kleinix16/Diplomova-Praca/media/Testovanie (1).jpg

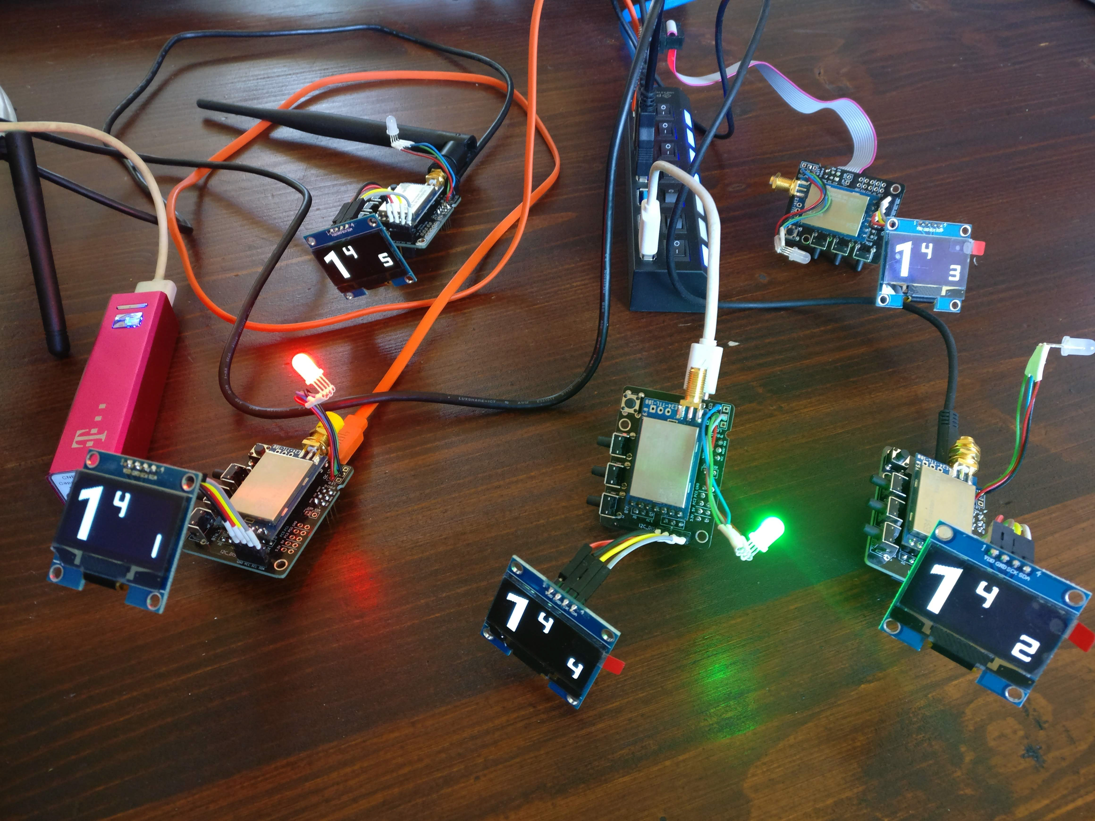
media/Testovanie (1).jpg
