kleinix16/Diplomova-Praca/media/SJ_Nasadenie do prevadzky (1).jpg

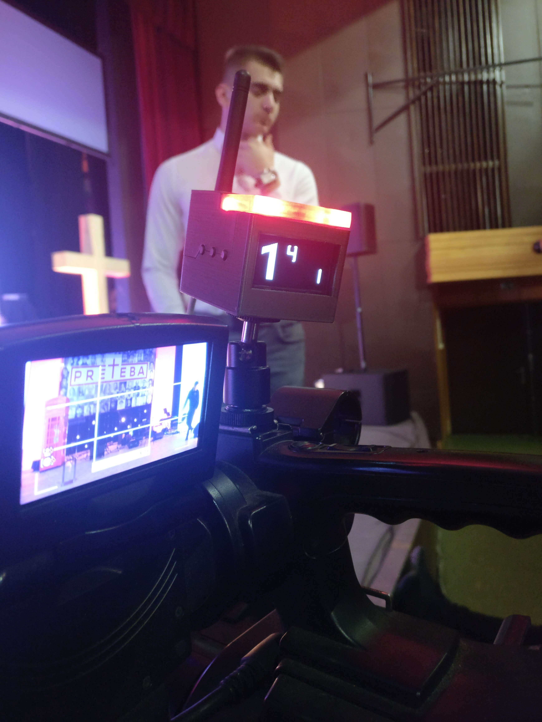
media/SJ_Nasadenie do prevadzky (1).jpg
