kleinix16/Diplomova-Praca/README.md

# Diplomová práca - Komunikačný systém pre kameramanov

Autor: Bc. Tomáš Klein  
Vedúci práce:  prof. Ing. Juraj Miček, PhD.  
Registračné číslo:  28360820192562  
Rok vydania: Žilina, 2019 

Abstrakt: Diplomová práca sa zaoberá riešením problému komunikácie medzi režisérom a kameramanmi pri vytváraní kamerového záznamu pomocou zariadenia video-strižňa. Práca popisuje vytvorenie komunikačného systému, ktorý bude na kamery prenášať Tally svetelnú signalizáciu využitia kamier a krátke textové správy odosielané z Android zariadenia. V úvode práce je popísaná bezdrôtová komunikácia, so zameraním na bezlicenčné frekvenčné pásma. Ďalej práca obsahuje analýzu zadania, v ktorej je podrobnejšie rozobraný návrh celého systému. Táto časť obsahuje porovnanie a výber komponentov komunikačného systému. Implementačná časť práce sa venuje prepojeniu všetkých analyzovaných komponentov a obsahuje základné postupy a algoritmy, využívané pri riešení. 

Kľúčové slová:  ISM, Tally, Mikrokontrolér, Android, Bluetooth   

Súbory: dokumentácia, zdrojové kódy, android aplikácia, 3D model obalu, schémey, diagramy
