kleinix16/Diplomova-Praca/dokumentacia/DP.pptx

## Komunikačný systém pre kameramanov

ŽILINSKÁ UNIVERZITA V ŽILINE
FAKULTA RIADENIA A INFORMATIKY

Diplomová práca
Bc. Tomáš Klein (557478)
Registračné číslo: 28360820192562
Vedúci práce: prof. Ing. Juraj Miček, PhD.

## Ciele práce

- Vytvorenie komunikačného systém pre kameramanov, ktorý spolupracujú na vytvorení spoločného video-záznamu – napr. živý prenos ľadového hokeja
- Tally svetelná signalizácia
- Bezdrôtový prenos

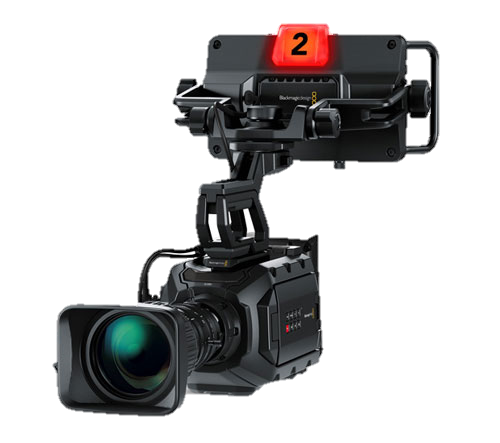
[picture p3: figure]

## Popis systému

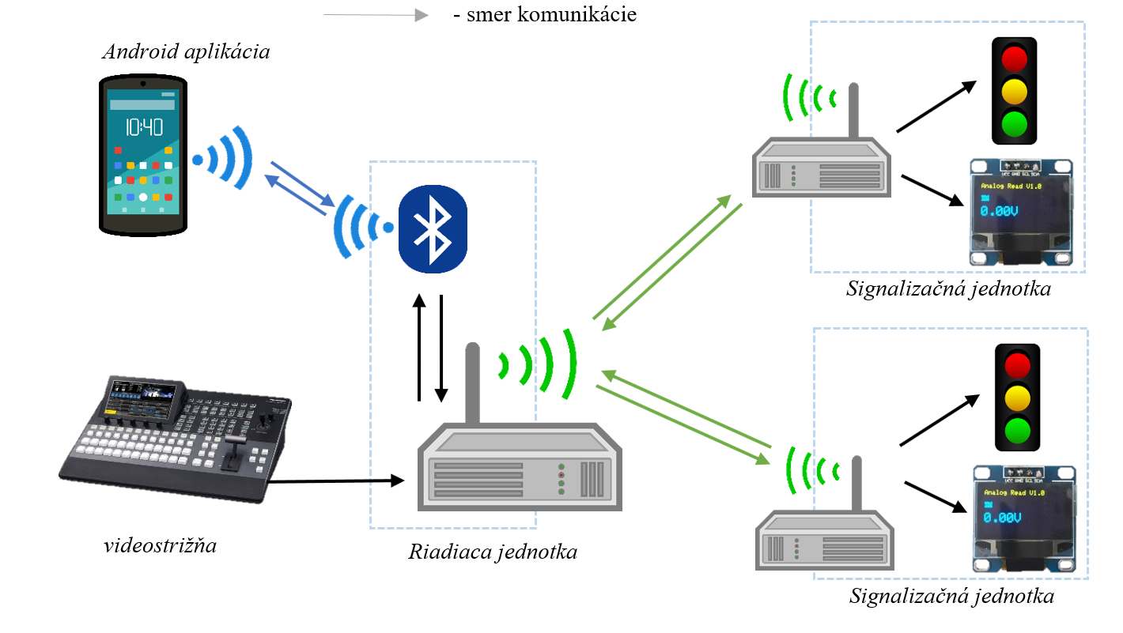
[picture p4: figure]

## Bezdrôtový prenos

- Analýza bezlicenčných pásiem
  - 433 – 434 MHz
  - 863 – 870 MHz
  - 2400 – 2500 MHz
- Výber vhodného modulu
  - Pomer cena/kvalita
  - Možnosť výmeny modulu na iný
  - Firma CDEbyte

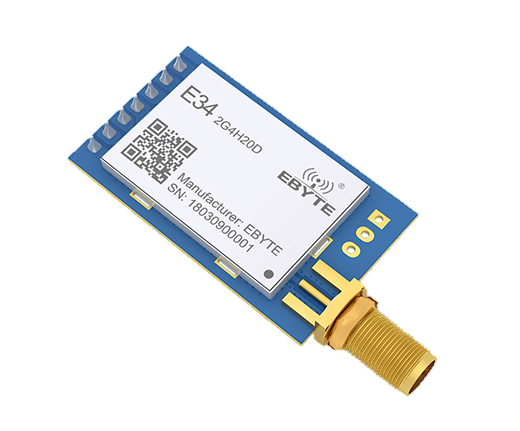
[picture p5: figure]

## Riadiaca stanica

- Zber dát z video-strižňe
- Komunikácia s Android aplikáciou pomocou Bluetooth
- Komunikácia so signalizačnými jednotkami
- Android aplikácia – MIT APP Inventor
  - Programovanie pomocou online grafického prostredia
  - Posielanie a prijímanie textových správ

## Slide 6

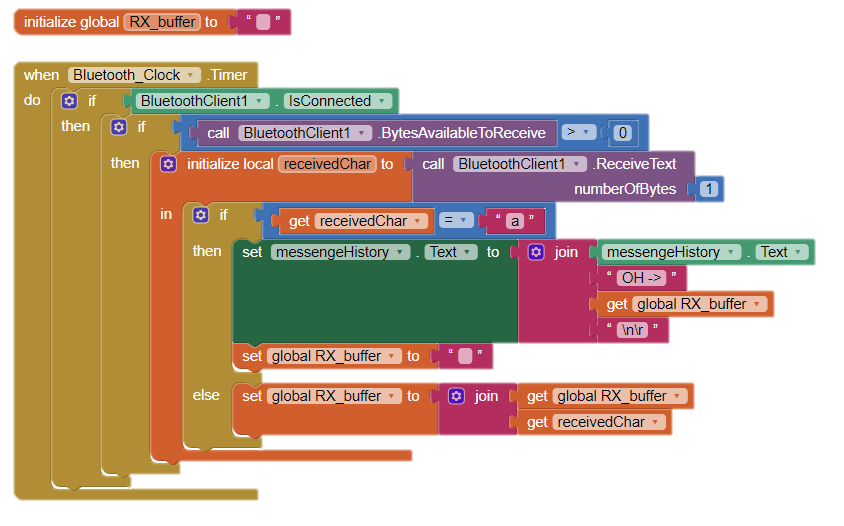
[picture p6: figure]

## Signalizačná jednotka

- Komunikácia s riadiacou stanicou
- Riadenie LED diód
- Zobrazovanie dát na displeji
- Odpovedanie na textové správy
- Napájanie z USB rozhrania
- Dôraz na malé rozmery a estetickú časť

## Výhody riešenia

- Možnosť prispôsobenia systému
- Cena
- Rozšíriteľnosť funkcionality
  - Android aplikácia
  - Možnosť vzdialeného ovládania video-strižne
  - Jednosmerný prenos hlasových povelov z réžie

## Záver

- Ciele boli splnené
- Systém bol úspešne nasadený
- Osobný prínos
  - Vytvorenie komplexného riešenia

## Ďakujem za pozornosť

ŽILINSKÁ UNIVERZITA V ŽILINE
FAKULTA RIADENIA A INFORMATIKY

Diplomová práca
Bc. Tomáš Klein (557478)
Registračné číslo: 28360820192562
Vedúci práce: prof. Ing. Juraj Miček, PhD.
