kleinix16/Diplomova-Praca/media/Android_APP (1).jpg

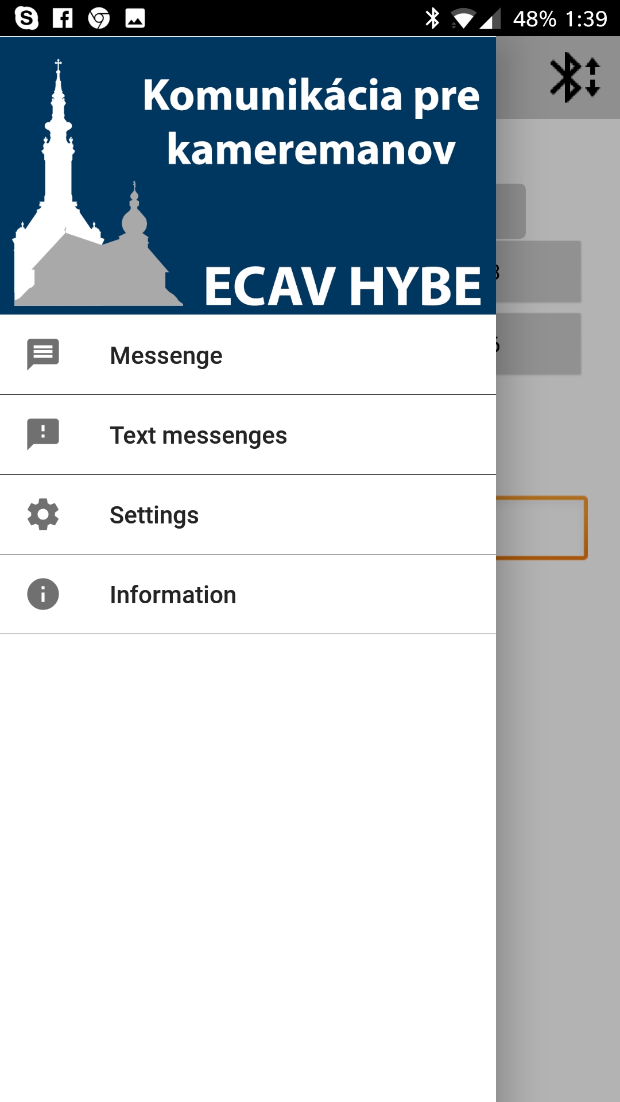
media/Android_APP (1).jpg
