kleinix16/Diplomova-Praca/media/Android_APP (2).jpg

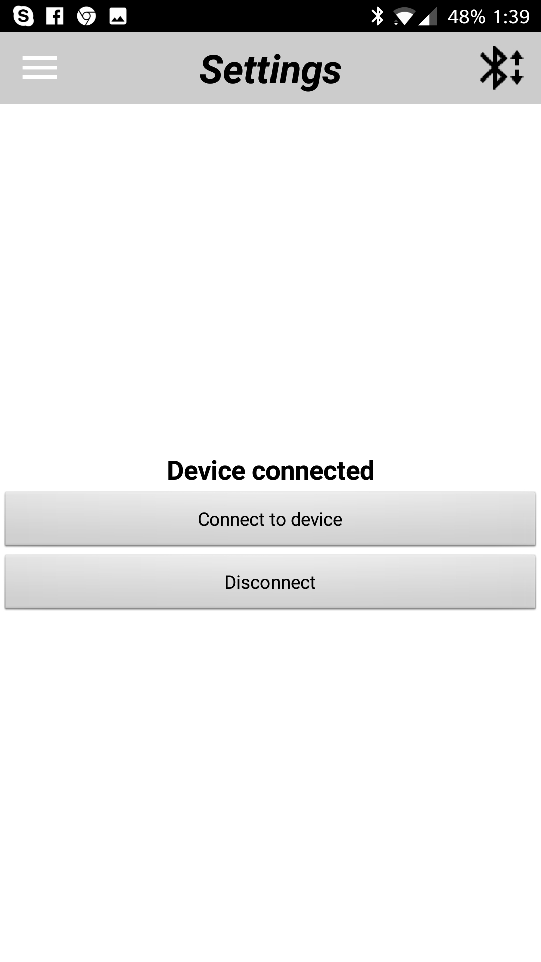
media/Android_APP (2).jpg
