kleinix16/Diplomova-Praca/media/Android_APP (3).jpg

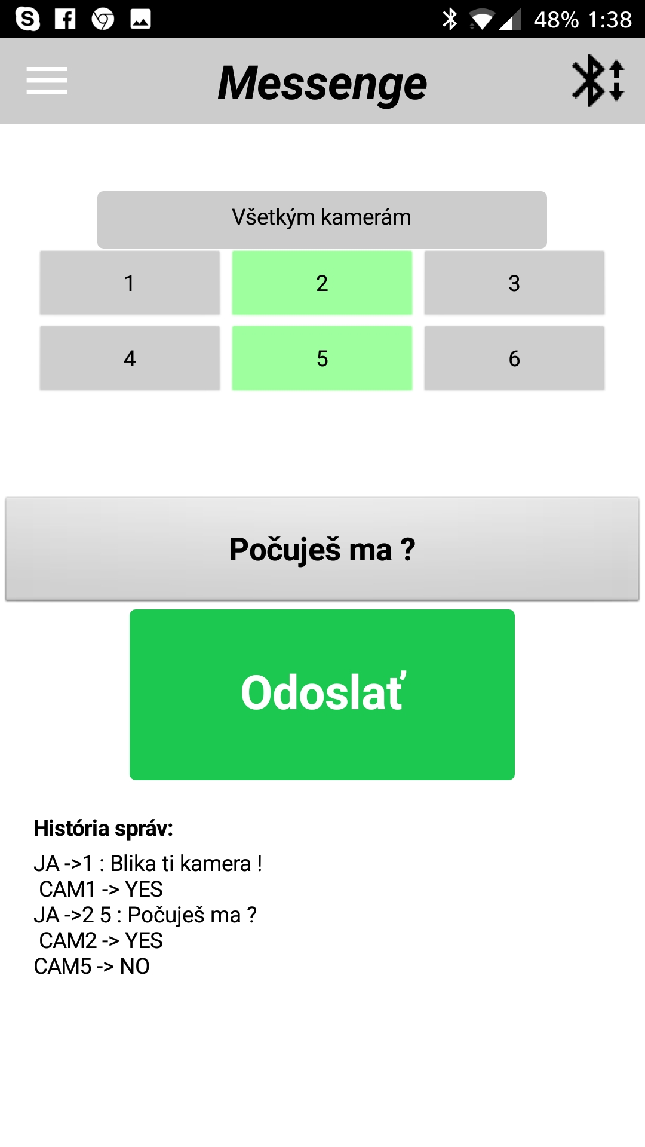
media/Android_APP (3).jpg
