kleinix16/Diplomova-Praca/media/Displej (1).jpg

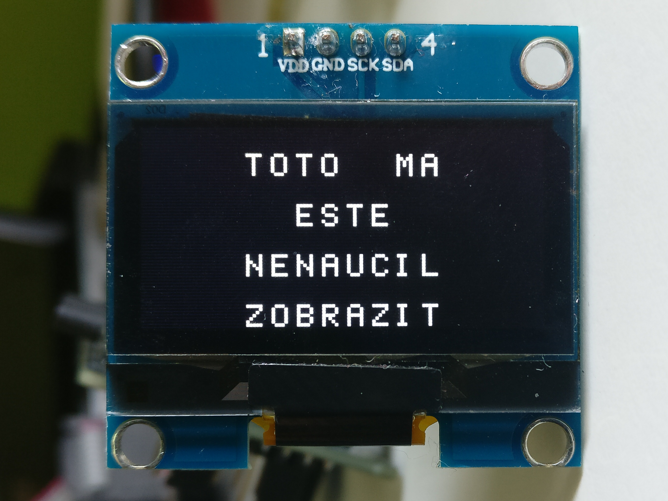
media/Displej (1).jpg
