kleinix16/Diplomova-Praca/media/Displej (2).jpg

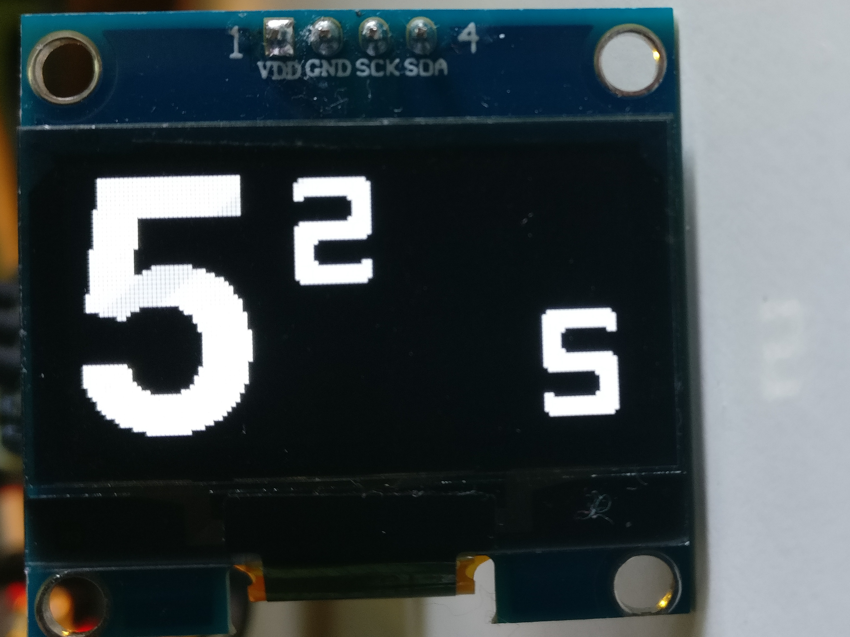
media/Displej (2).jpg
