kleinix16/Diplomova-Praca/media/Riadiaca stanica (1).jpg

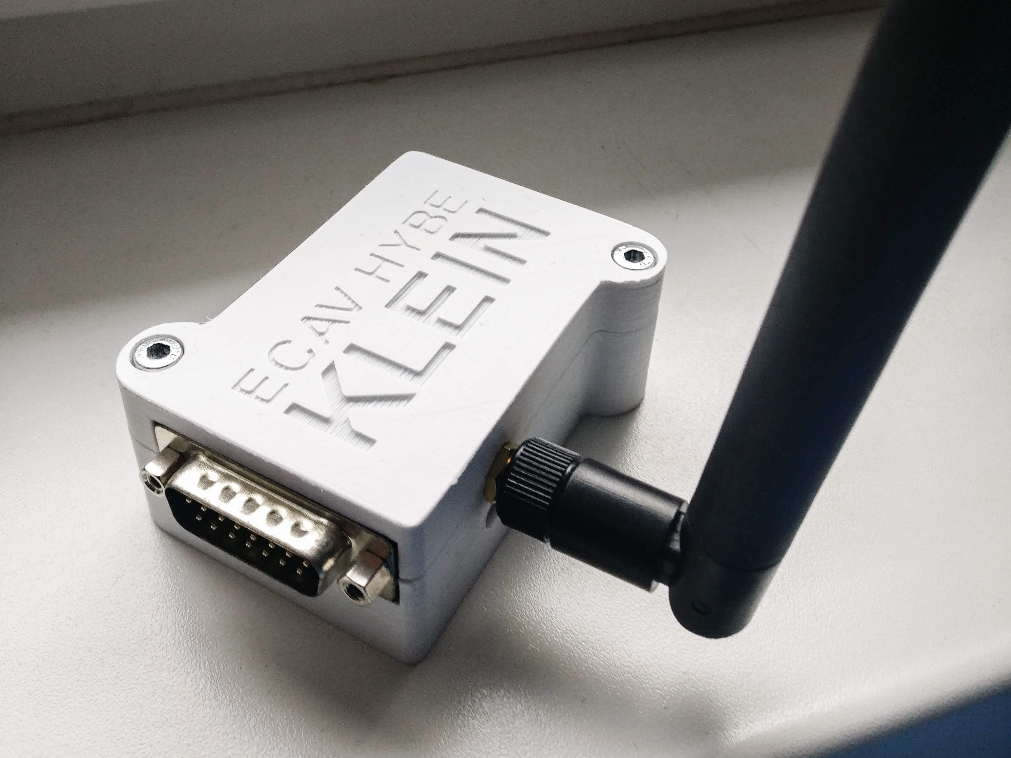
media/Riadiaca stanica (1).jpg
