kleinix16/Diplomova-Praca/media/Signalizacna jednotka (1).jpg

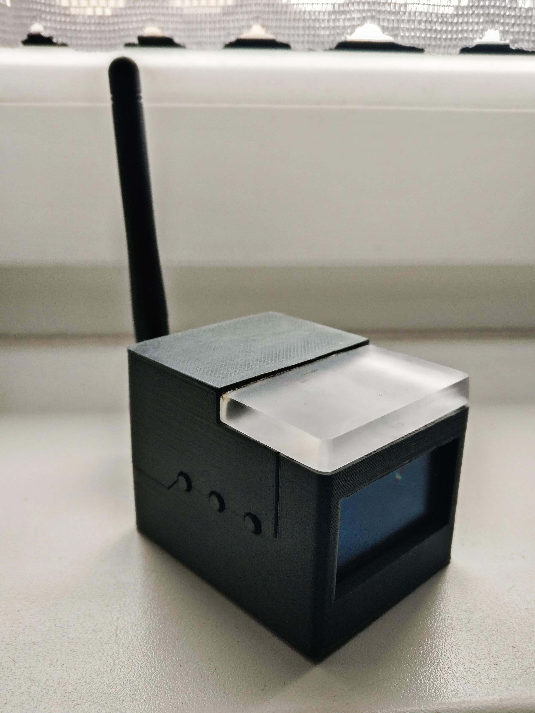
media/Signalizacna jednotka (1).jpg
