kleinix16/Diplomova-Praca/media/Signalizacna jednotka (2).jpg

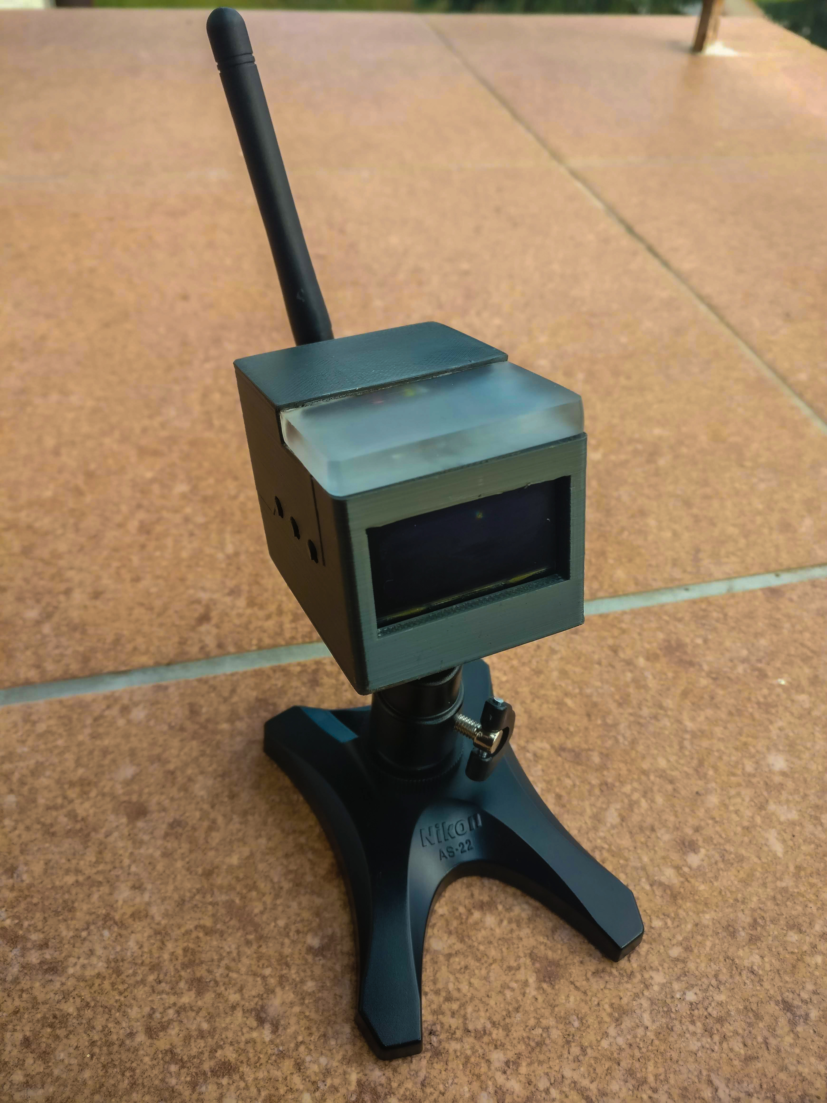
media/Signalizacna jednotka (2).jpg
