kleinix16/Diplomova-Praca/media/SJ_Nasadenie do prevadzky (2).jpg

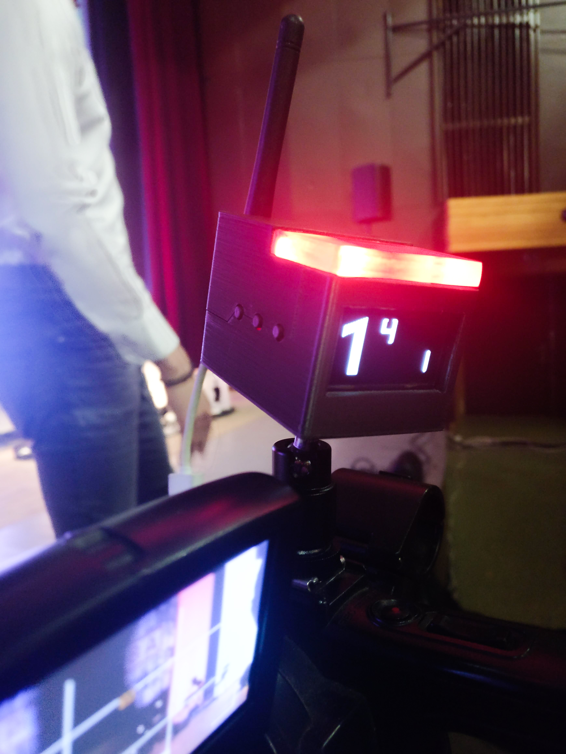
media/SJ_Nasadenie do prevadzky (2).jpg
