kleinix16/Diplomova-Praca/media/SJ_Tally - Live.jpg

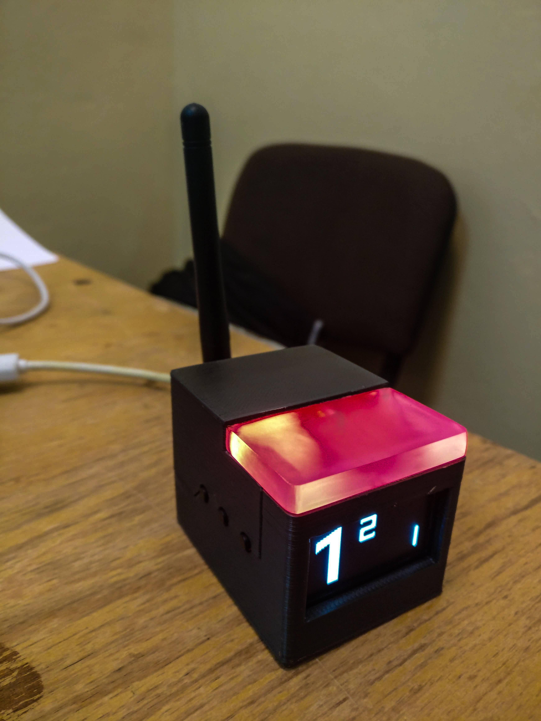
media/SJ_Tally - Live.jpg
