kleinix16/Diplomova-Praca/media/SJ_Tally - Ready.jpg

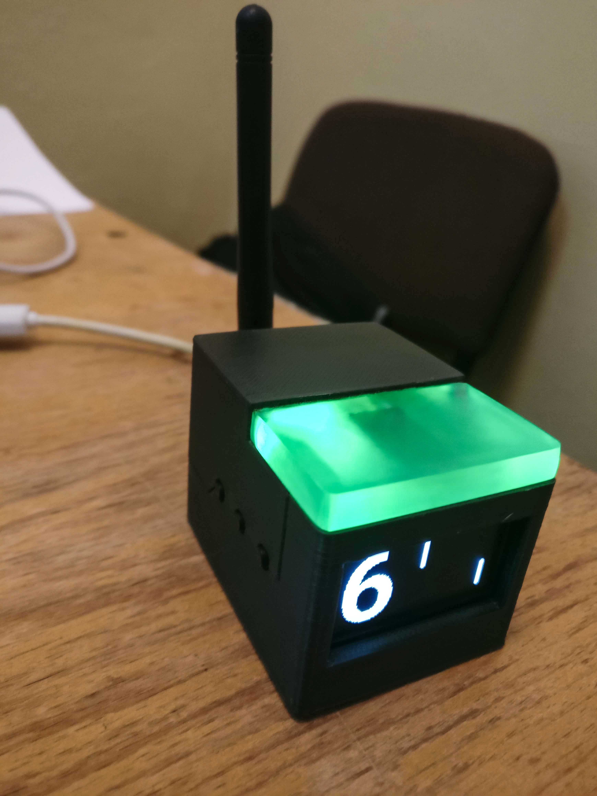
media/SJ_Tally - Ready.jpg
