kleinix16/Diplomova-Praca/(list of files, cad)

Other CAD files:
zdrojove_subory/Riadiaca_stanica_3D_obal.f3d
zdrojove_subory/Signalizacna_jednotka_3D_obal.f3d
