kleinix16/Diplomova-Praca/Schemy/Riadiaca_stanica/riadiaca_stanica.kicad_pcb

## KiCad design Schemy/Riadiaca_stanica/riadiaca_stanica.kicad_pcb (2019-01-26)

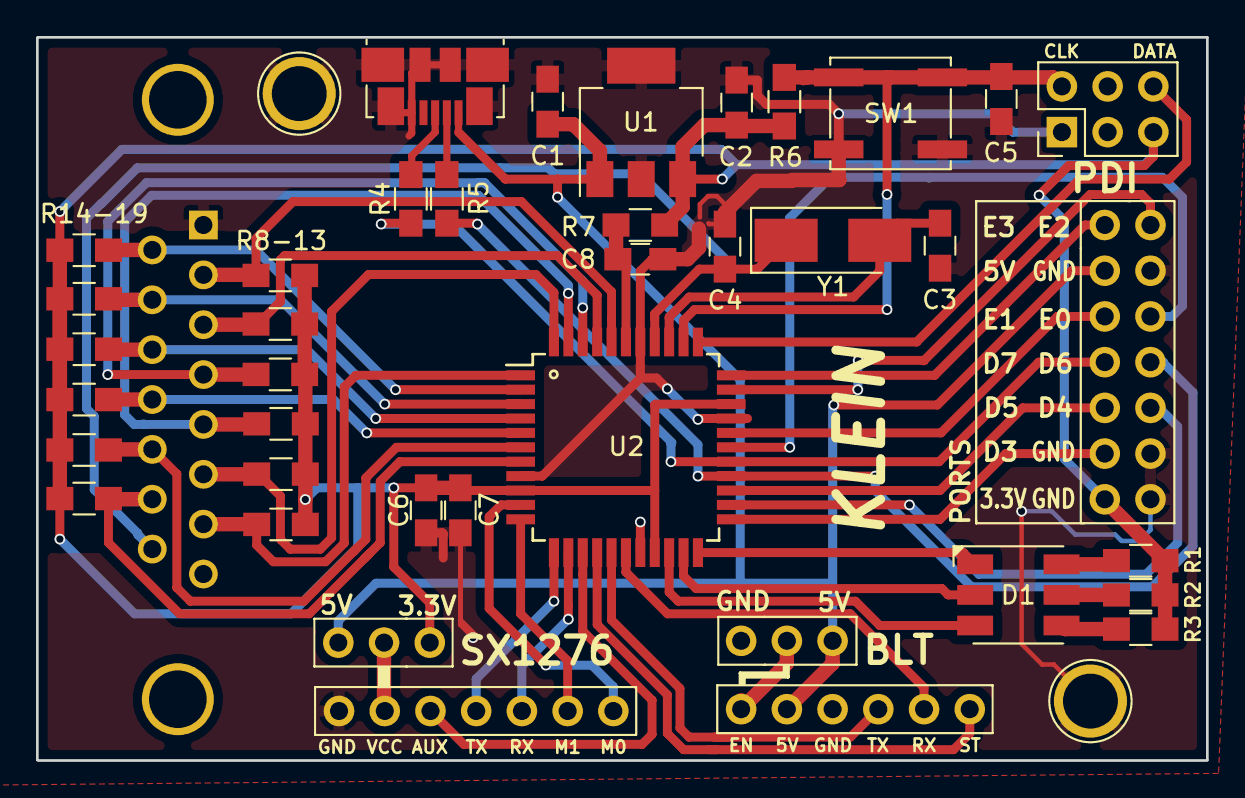
[picture p18: board riadiaca_stanica.kicad_pcb from above]

Board: 2 copper layers, 65.0 x 40.2 mm, 30 parts (0 on the bottom side), 37 nets.

Parts:
 : 1pin
 #2: USB_OTG; USB_Micro-B_Molex_47346-0001
 #3,  #4: Jumper; PIN_3_moj
 #5: PID; PIN_6_moj
 #6: Inter; PIN_12_moj
 #7: BLUETOOTH; PIN_6_moj
 #8: LoRa - SX1276; PIN_7_moj
C1, C5, C7, C8: M1; C_0805_HandSoldering
C2: 22M; C_0805_HandSoldering
C3, C4: C; C_0805_HandSoldering
C6: 2M2; C_0805_HandSoldering
D1: LED_RGB; LED_RGB_5050-6
R1, R2, R3, R4, R5, R14-19: R; R_0805_HandSoldering
R6: M1; R_0805_HandSoldering
R7: 100R; R_0805_HandSoldering
R8-13: 4k7; R_0805_HandSoldering
SW1: RESET; SW_SPST_EVQP0
U1: SOT 233; SOT-223-3_TabPin2
U2: ATXMEGA128A4-AU; CPU_moj
Y1: Crystal; Crystal_SMD_5032-2pin_5.0x3.2mm_HandSoldering

Connections:
+3V3: #3.1, #5.2, #6.13, C2.1, C6.1, C7.1, R1.2, R2.2, R3.2, R6.1, R7.2, R8-13.1, R14-19.1, U1.3, U2.9, U2.19, U2.31
+5V: #2.1, #3.3, #4.3, #6.3, #7.5, C1.1, U1.1
/L1: R14-19.2, U2.2
/R1: R8-13.2, U2.40
AUX_LORA: #8.5, U2.14
B_LED: D1.1, U2.22
GND: .1, #2.5, #2.6, #4.1, #5.6, #6.4, #6.12, #6.14, #7.4, #8.7, C1.2, C2.2, C3.1, C4.1, C5.1, C6.2, C7.2, C8.2, SW1.1, U1.2, U2.8, U2.18, U2.30, U2.38
G_LED: D1.2, U2.21
M0_LORA: #8.1, U2.10
M1_LORA: #8.2, U2.11
unnamed: C3.2, U2.36, Y1.2
unnamed: C4.2, U2.37, Y1.1
unnamed: C8.1, R7.1, U2.39
unnamed: D1.4, R3.1
unnamed: D1.5, R2.1
unnamed: D1.6, R1.1
unnamed: #2.2, R5.2
unnamed: #2.3, R4.2
unnamed: #4.2, #7.6
unnamed: #3.2, #8.6
PD3: #6.11, U2.23
PD4: #6.10, U2.24
PD5: #6.9, U2.25
PD6: #6.8, R5.1, U2.26
PD7: #6.7, R4.1, U2.27
PDI_CLK: #5.5, C5.2, R6.2, SW1.2, U2.35
PDI_DATA: #5.1, U2.34
PE0: #6.6, U2.28
PE1: #6.5, U2.29
PE2: #6.2, U2.32
PE3: #6.1, U2.33
RX_BLT: #7.2, U2.17
RX_LORA: #8.3, U2.13
R_LED: D1.3, U2.20
STATE_BLT: #7.1, U2.15
TX_BLT: #7.3, U2.16
TX_LORA: #8.4, U2.12
