kleinix16/Diplomova-Praca/Schemy/Signalizacna_jednotka/signalizacna_jednotka.kicad_pcb

## KiCad design Schemy/Signalizacna_jednotka/signalizacna_jednotka.kicad_pcb (2019-01-26)

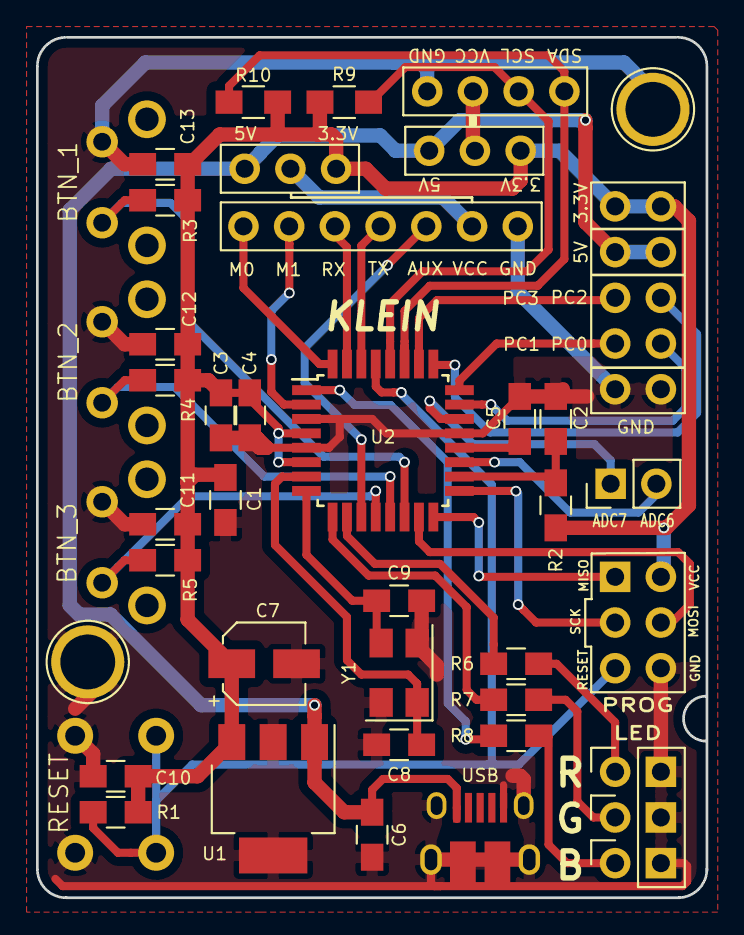
[picture p19: board signalizacna_jednotka.kicad_pcb from above]

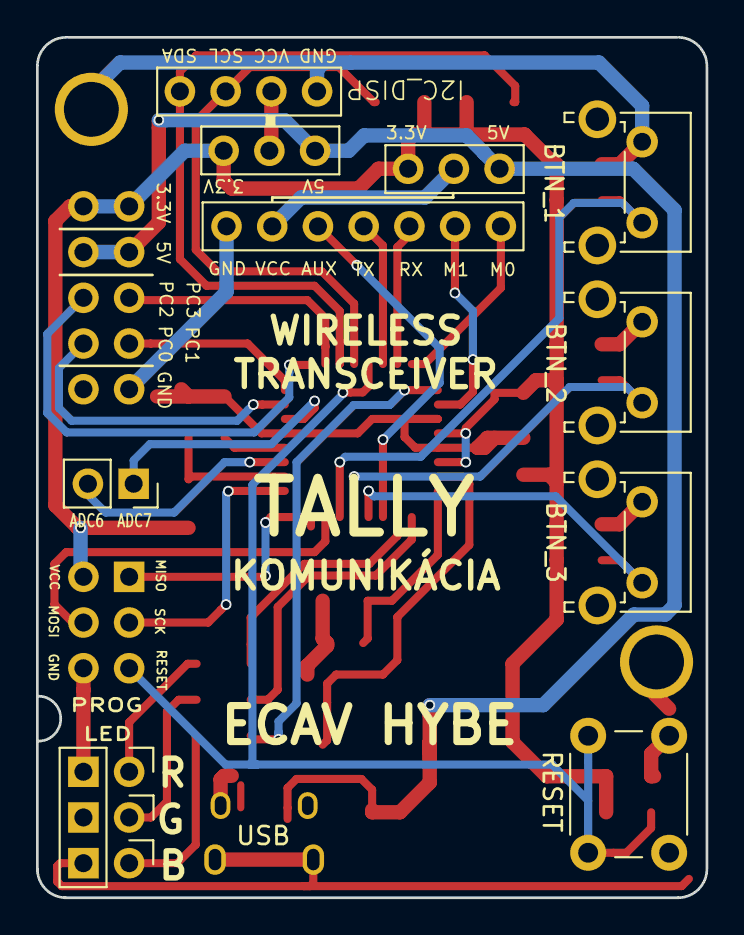
[picture p20: board signalizacna_jednotka.kicad_pcb from below]

Board: 2 copper layers, 37.2 x 47.8 mm, 39 parts (5 on the bottom side), 35 nets.

Parts:
BTN_1, BTN_2, BTN_3: SW_Push; SW_Tactile_SPST_Angled_PTS645Vx83-2LFS
C1, C2, C4, C5, C6, C10, C11, C12, C13: M1; C_0805_HandSoldering
C3: 2M2; C_0805_HandSoldering
C7: 22M; CP_Elec_4x5.8
C8, C9: 18pF; C_0805_HandSoldering
J1: USB_OTG; USB_Micro-B_10103594-0001LF
J2: Analog_only; Pin_Header_Straight_1x02_Pitch2.54mm
J3: PROG; Pin_Header_Straight_2x03_Pitch2.54mm
J4: EXT; Pin_Header_Straight_2x05_Pitch2.54mm
J5: LEDS; Pin_Header_Straight_2x03_Pitch2.54mm
J6: LoRa - RFM; Pin_Header_Straight_1x07_Pitch2.54mm
J7: DISPLAY_I2C; Pin_Header_Straight_1x04_Pitch2.54mm
JP1, JP2: Jumper; Pin_Header_Straight_1x03_Pitch2.54mm
R1, R3, R4, R5, R6, R7, R8: R; C_0805_HandSoldering
R2: 100R; C_0805_HandSoldering
R9, R10: R; R_0805_HandSoldering
RESET: RESET; SW_PUSH_6mm
U1: SOT 233; SOT-223-3_TabPin2
U2: ATMEGA328P-AU; TQFP-32_7x7mm_Pitch0.8mm
Y1: Crystal_GND24; Crystal_SMD_5032-4pin_5.0x3.2mm

Connections:
+3V3: C1.1, C3.1, C4.1, C7.1, C10.1, C11.1, C12.1, C13.1, J3.2, J4.1, J4.2, JP1.1, JP2.1, R1.2, R2.2, R3.2, R4.2, R5.2, R9.1, R10.1, U1.3, U2.4, U2.6
+5V: C6.1, J1.1, J4.3, J4.4, JP1.3, JP2.3, U1.1
AUX_LORA: J6.5, U2.11
BTN_1: BTN_1.2, R3.1, U2.14
BTN_2: BTN_2.2, R4.1, U2.13
BTN_3: BTN_3.2, R5.1, U2.12
B_LED: R8.2, U2.1
GND: BTN_1.1, BTN_2.1, BTN_3.1, C1.2, C2.1, C3.2, C4.2, C5.1, C6.2, C7.2, C8.2, C9.2, C10.2, C11.2, C12.2, C13.2, J1.5, J1.6, J3.6, J4.9, J4.10, J5.2, J5.4, J5.6, J6.7, J7.4, RESET.1, U1.2, U2.3, U2.5, U2.21, Y1.2, Y1.4
G_LED: R7.2, U2.9
M0_LORA: J6.1, U2.32
M1_LORA: J6.2, U2.2
unnamed: C2.2, R2.1, U2.18
unnamed: C5.2, U2.20
unnamed: C8.1, U2.7, Y1.1
unnamed: C9.1, U2.8, Y1.3
unnamed: J2.1, U2.22
unnamed: J2.2, U2.19
unnamed: J3.1, U2.16
unnamed: J3.3, U2.17
unnamed: J3.4, U2.15
unnamed: J5.1, R6.1
unnamed: J5.3, R7.1
unnamed: J5.5, R8.1
unnamed: J6.6, JP1.2
unnamed: J7.3, JP2.2
PC0: J4.8, U2.23
PC1: J4.7, U2.24
PC2: J4.6, U2.25
PC3: J4.5, U2.26
RESET: J3.5, R1.1, RESET.2, U2.29
RX_LORA: J6.3, U2.31
R_LED: R6.2, U2.10
SCL: J7.2, R9.2, U2.28
SDA: J7.1, R10.2, U2.27
TX_LORA: J6.4, U2.30
