kleinix16/Diplomova-Praca/zdrojove_subory/Signalizacna_jednotka/dispalyData.h

/* 
 * This file contains all the static arrays to draw things in the display.
 * you can create your own fonts using this tool https://www.mikroe.com/glcd-font-creator
 */

#include <avr/pgmspace.h>
typedef uint8_t bitmap_t[8][128];
typedef char PROGMEM prog_uchar;

// Big numbers font, from 0 to 9. 96 byte each.
// Bold Roboto Mono 32 - 24 x 32
const int widthReadyFont = 24;
const prog_uchar readyNumbers[][96] PROGMEM = {
	{0x0, 0x0, 0x0, 0x0, 0xc0, 0xf0, 0xf8, 0xfc, 0xfc, 0xfe, 0x3e, 0x3e, 0x3e, 0x3e, 0x3e, 0x7e, 0xfc, 0xfc, 0xfc, 0xf8, 0xf0, 0xc0, 0x0, 0x0, 0x0, 0x0, 0x0, 0xff, 0xff, 0xff, 0xff, 0xff, 0xff, 0x0, 0x0, 0x80, 0x80, 0xc0, 0xe0, 0xf0, 0x70, 0xff, 0xff, 0xff, 0xff, 0xff, 0xfe, 0x0, 0x0, 0x0, 0x0, 0xff, 0xff, 0xff, 0xff, 0xff, 0xff, 0xe, 0xf, 0x7, 0x3, 0x3, 0x1, 0x0, 0x0, 0xff, 0xff, 0xff, 0xff, 0xff, 0x7f, 0x0, 0x0, 0x0, 0x0, 0x0, 0x3, 0xf, 0x1f, 0x3f, 0x3f, 0x7f, 0x7c, 0x7c, 0x7c, 0x7c, 0x7c, 0x7e, 0x3f, 0x3f, 0x3f, 0x1f, 0xf, 0x3, 0x0, 0x0},
	{0x0, 0x0, 0x0, 0x0, 0xe0, 0xe0, 0xf0, 0xf0, 0xf0, 0xf8, 0xf8, 0xf8, 0xfc, 0xfc, 0xfe, 0xfe, 0xfe, 0x0, 0x0, 0x0, 0x0, 0x0, 0x0, 0x0, 0x0, 0x0, 0x0, 0x0, 0x3, 0x3, 0x1, 0x1, 0x1, 0x0, 0x0, 0xff, 0xff, 0xff, 0xff, 0xff, 0xff, 0x0, 0x0, 0x0, 0x0, 0x0, 0x0, 0x0, 0x0, 0x0, 0x0, 0x0, 0x0, 0x0, 0x0, 0x0, 0x0, 0x0, 0x0, 0xff, 0xff, 0xff, 0xff, 0xff, 0xff, 0x0, 0x0, 0x0, 0x0, 0x0, 0x0, 0x0, 0x0, 0x0, 0x0, 0x0, 0x0, 0x0, 0x0, 0x0, 0x0, 0x0, 0x0, 0x7f, 0x7f, 0x7f, 0x7f, 0x7f, 0x7f, 0x0, 0x0, 0x0, 0x0, 0x0, 0x0, 0x0},
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
	};
