kleinix16/Diplomova-Praca/(commit log)

2019-01-26 Pridanie funkcnej casti kodu na ovladanie I2C displeja, nutnost integracie a revizie kodu
2019-01-26 Pridanie schem do GIT priecinku
    [Prijmac-B.Cu.gbr, Prijmac-B.Mask.gbr, Prijmac-B.SilkS.gbr, Prijmac-Edge.Cuts.gbr, Prijmac-F.Cu.gbr, Prijmac-F.Mask.gbr, Prijmac-F.SilkS.gbr, Prijmac.drl]
2019-01-31 Pridanie dokumentácie na Projektovú výučbu
    [Projekt P1 P3 ZS 2018 19 PI final čas harmonogram kopia.xls]
2019-02-16 Prijmac - implementacia tlacidiel a to vsetko uz na novej soske
    [Tabulky.xlsx]
2019-03-02 pridanie textov do wordu
    [Tabulky.xlsx]
2019-03-19 pokrok v texte
    [Tabulky.xlsx]
2019-03-23 Upravene schemy
    [Prijmac-B.Cu.gbr, Prijmac-B.Mask.gbr, Prijmac-B.SilkS.gbr, Prijmac-Edge.Cuts.gbr, Prijmac-F.Cu.gbr, Prijmac-F.Mask.gbr, Prijmac-F.SilkS.gbr, Prijmac.drl]
2019-03-29 uprava zloziek a kodu signalizacnej jednotky
    [Projekt P1 P3 ZS 2018 19 PI final čas harmonogram kopia.xls, Tabulky.xlsx]
2019-03-30 Hruba editacia textu ukoncena
    [Projekt P1 P3 ZS 2018 19 PI final čas harmonogram kopia.xls, Tabulky.xlsx]
2019-03-31 Kod v1.0
    [Tabulky.xlsx]
2019-03-31 Doc bez finalnych obrazkov
    [Riadiaca_stanica.f3d, Signalizacna_jednotka.f3d]
2019-04-09 Uprava priecinkov a odstranenie chyby SJ s Live signalizaciou
    [Riadiaca_stanica_3D_obal.f3d, Signalizacna_jednotka_3D_obal.f3d]
2019-04-09 Odovdanie veducemu prace - pripojene multimedia
    [Projekt P1 P3 ZS 2018 19 PI final čas harmonogram kopia.xls, Tabulky.xlsx]
